NielsBo/WavinESP32/(commit log)

2026-07-22 Wavin AHC9000 to HTTP bridge for ESP32
    Firmware that reads room temperatures, setpoints and heat demand from a
    Wavin AHC9000 (OEM: Jablotron AC-116) over RS-485 Modbus RTU and exposes
    them as a JSON API. Built for ESP32-WROOM-32 with the Arduino IDE.
    - wavin_modbus: RS-485 transport with CRC16, framing and the vendor
    function codes 0x43 (read), 0x44 (write) and 0x45 (masked write).
    Transactions are serialised; success/error counters are exposed.
    - wavin_domain: register constants and decoding for elements, rooms
    (packed data) and channels, plus setpoint and mode control. Mode
    changes use a masked write so lock/floor/cooling bits are preserved.
    - http_api: GET /health, GET /rooms, GE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
    [WavinEsp32.ino, config.h, http_api.cpp, http_api.h, status_led.cpp, status_led.h, wavin_domain.cpp, wavin_domain.h]
2026-07-22 Poll incrementally so a dead bus cannot stall the loop
    Previously a full sweep read all elements in one burst. With a silent bus
    every transaction burned the full timeout, blocking loop() for ~10s per
    cycle - which froze HTTP, OTA and the status LED at exactly the moment
    /health was needed to diagnose the problem.
    - Poll one element per pass, spread over POLL_INTERVAL_MS. Worst-case
    blocking is now a single transaction instead of a whole sweep.
    - Cut RESPONSE_TIMEOUT from 1000ms to 300ms; a healthy AHC9000 replies
    in single-digit ms, and this bounds the worst case above.
    - Back off an element for 5 minutes after FAIL_THRESHOLD consecutive
    failures, so empty pages and dead thermostats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
    [WavinEsp32.ino, config.h, wavin_domain.cpp, wavin_domain.h]
2026-07-22 Add per-room cooling mode control
    COOL MODE (PACKED DATA config bit 13) inverts a room's control loop: the
    actuator opens when the room is above setpoint instead of below. It was
    already decoded and exposed as the read-only "cooling" field; this makes
    it writable.
    - setRoomCooling() uses a masked write (0x45) with mask ~0x2000, so only
    COOL MODE is touched and the room's mode, lock and floor bits survive.
    - POST /rooms/<id> now accepts {"cooling":true|false}.
    Primary use here is heat redistribution rather than air conditioning:
    put an over-warm room into cooling so its loop absorbs heat into the
    circulating water, and let rooms still in heating release it. README
    documents the condition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
    [http_api.cpp, wavin_domain.cpp, wavin_domain.h]
2026-07-22 Add relay override and a client integration guide
    The AHC9000 signals the heat source through a relay whose ASSIGNMENT MAP
    decides which channels can switch it. Clearing that map suppresses the
    call for heat - the missing piece for heat redistribution, which needs
    the pump running while the heat source stays off.
    That register is non-volatile on the controller, so a naive on/off is
    dangerous: a crash or a forgotten call would leave the house unheated
    with nothing to explain why. Every override is therefore
    * time limited - default 30 min, hard capped at 4 h, no indefinite
    disable; each request extends the deadline
    * persisted to NVS - the original bitmap is s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
    [WavinEsp32.ino, config.h, http_api.cpp, relay_control.cpp, relay_control.h, wavin_domain.h]
2026-07-22 Report ESP32 die temperature in /health
    Adds a chipTemp field (degC, 1 decimal, null when unavailable) so an
    overheating enclosure shows up as a trend without opening the box.
    Core 3.x has temperatureRead() on every target; on the classic ESP32
    under core 1.x/2.x only the misspelled ROM function exists, returns
    Fahrenheit, and reports 128 on rev 0 silicon that has no sensor.
    [http_api.cpp]
2026-07-24 docs(hardware): document the enclosure with generated renders
    Add hardware/README.md with dimensions, annotated views and printing
    notes, and link it from the main README.
    The renders are generated by render.sh rather than hand-exported, so they
    can be refreshed when the .scad changes. It forces --render=cgal: the
    default OpenCSG preview drops thin walls inside a difference(), which
    makes the lid skirt look like it has holes through it.
